simple-circuit/6800-Trainer/key labels.pdf

# 0123456789ABCD

UART OUT
UART IN
GND

D6 OUT
D7 OUT
GND

TRACE ON

PICO RESET

6800 RESET

TRAINER
UART

GND
D2IN
60HZ
SW
IRQ
NMI

+5V
GND
3.3V
GND
A3
A2
A1
D Do | E Examine | F Forward
A Auto | B Back | C Change
7 RTI | 8 Single Step 9 Break Point
4 IndeX | 5 CC | 6 SP2
1 ACCA | 2 ACCB | 3 PC
0 | Grey 0x20 | Red 0x10 Exit

F

E
