simple-circuit/6800-Trainer/(notices)

Notices in the files:
Mini Trainer/sim680b_trainer_i2c_s/sim680b_trainer_i2c_s.ino:
This program is free software: you can redistribute it and/or modify
it under the terms of the GNU General Public License as published by
the Free Software Foundation, either version 3 of the License, or
(at your option) any later version.
